Ashenstride/Biochar-Toilet/Project Files/CAD Files/Proper_Pressure_Vessel_Hawkins_12L_with_Real_Dimensions.FCStd

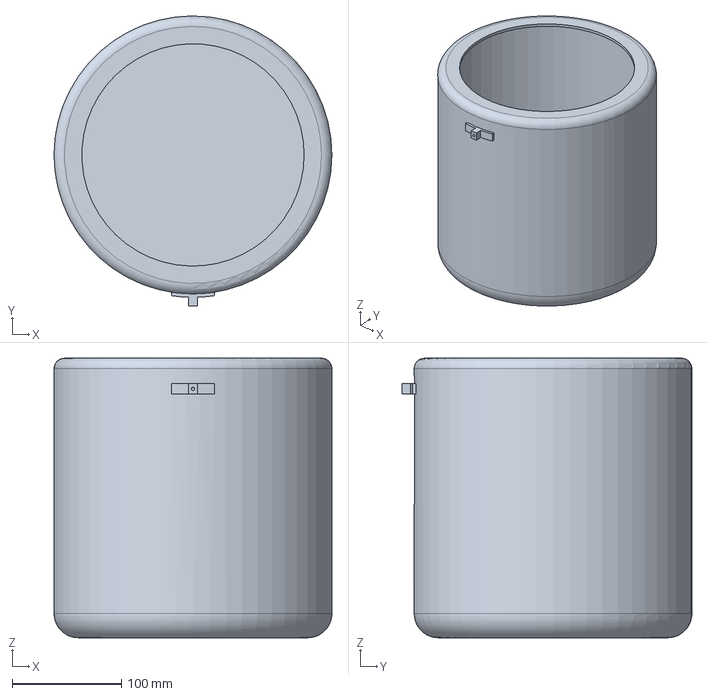
[picture p1: CAD file, 2026-06-08]
Project Files/CAD Files/Proper_Pressure_Vessel_Hawkins_12L_with_Real_Dimensions.FCStd
254.0 x 265.1 x 255.6 mm
