Ashenstride/Biochar-Toilet/Project Files/CAD Files/Induction_Module_Clearance_model.FCStd

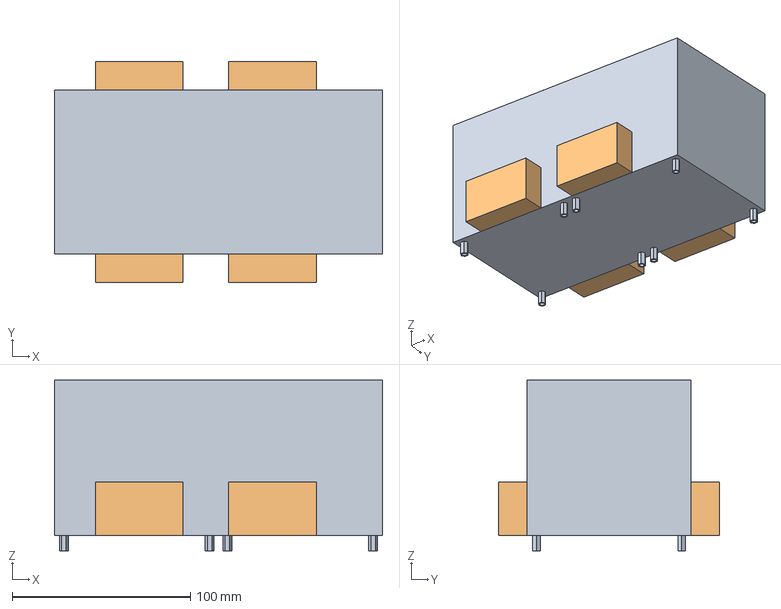
[picture p2: CAD file, 2026-06-05]
Project Files/CAD Files/Induction_Module_Clearance_model.FCStd
184.2 x 123.9 x 95.8 mm
