Ashenstride/Biochar-Toilet/Project Files/CAD Files/1inID_304ss_bulkhead fitting.FCStd

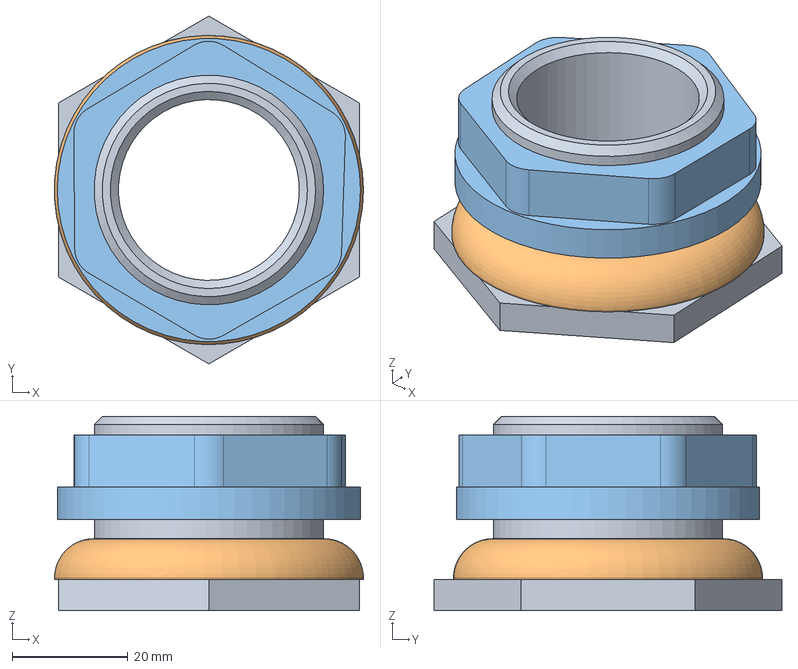
[picture p3: CAD file, 2026-06-05]
Project Files/CAD Files/1inID_304ss_bulkhead fitting.FCStd
53.3 x 60.0 x 33.5 mm
Seal
